RENO-WARNER/UTAH-TECH-CUBESAT/DOCUMENTATION/reports.md

# Utah Tech CubeSat: Reports Guide
## Contents

* [Intro](#intro)
* [Headers](#header)
* [Reports](#reports)
	* [Function](#function)
	* [Design](#design)
	* [Schematic](#schematic)
	* [Layout](#layout)
	* [Purchasing](#purchasing)
* []

## Intro
These reports will:
* Allow everyone to work independently
* Allow everyone to prove their work in a structured way.
* Allow everyone to understand 

**Report Content:**
Each subsystem development phase requires submitting the following reports:

## **Headers**
Each report will include a header with designated spaces for digital signatures through Git commits from:

* Subsystem Members
* Relevant Subsystem Leaders (if changes impact other subsystems)
* System Engineers
* Project Manager

[Template](./TEMPLATE/header.md)

**Don't fill in names in the header, only the associated person will sign**

**Don't forget to change the template name to your subsystem**

**When a revision needs to be made after a report has already been signed off, clone the header and increase the version number.**

## Reports
* [Function](#function)
* [Design](#design)
* [Schematic](#schematic)
* [Layout](#layout)
* [Purchasing](#purchasing)

### Function:
State the main functions of the subsystem along with the supporting functions.

[Template](./TEMPLATE/function.md)

Use ChatGPT / Gemini to get a good idea of the functions you will potentially need along with the supporting functions.
Go into detail with the functions as these need to represent all actions that your subsystem has. The functions do not need to include specific values for instance:

**DO**: The reation wheels will rotate at a speed that will allow the cubesat to track an ground station.

**DON'T**: Have motors that will spin at 1300 RPM.

This is because the design report will include all the calculations.
This will allow easy recaculation if our parameters change.

**Resources**
* [ASU Requirements List](https://dixiestate-my.sharepoint.com/:x:/g/personal/d00441759_utahtech_edu/EQHiULvhAddBqsvwDBeLyc0BcwGK4VwTQxvXV8os65FvTg)

### Design:

**Components**
This will be a list of all the active components needed.
E-Fuse 

**Analysis and Calculations**

for example:

**Selection**

Finally a Block Diagram of all the active components will be needed along will the power and communication between the components.

[Template](./TEMPLATE/design.md)

**Resources**
* Block Diagrams:
	* [Oresat](https://oresat.github.io/pub/OreSat0.5_Block_Diagram_v5.5_2023-04-025.pdf)
	* [Quetzal-1](https://github.com/Quetzal-1-CubeSat-Team/quetzal1-hardware) (Click the respecting subsystem)
* Papers
* OpenSource Satellites
* Spark

**[Easy Block Diagram Generator](https://app.diagrams.net/)**

### Schematic:

[Template](./TEMPLATE/schematic.md)

Creating a Schematic
Schematics will use the Utah Tech Cubesat Template

Everyone will use a Heicharchal Document
REFRENCE.schdoc will be used as

An Image of your Schematic

Use Template from Altium Designer Workspace make sure to fill out

Subsystem
Section
Version
Date

### Layout:

[Template](./TEMPLATE/layout.md)

### Test:
Describe test procedures to verify all functionalities.
### Reliability:
Analyze potential failure points and propose mitigation strategies.
### Purchasing
Request purchase approvals for components, consumables, and one-time purchases.

**Reports maybe excluded if they don't apply to your subsystem(eg. Structure)**
