RENO-WARNER/UTAH-TECH-CUBESAT/CONTROL/design.md

Gimbal Motors
* GBM4008H-150T
	* 46 mm Diameter
	* 21 mm Height
	* 0608 Bearing !!!!!
	* Voltage: 12V
	* 24N / 22P
* GM3506 
	* 18 OD 12 ID 4 W
	* 40 mm Diameter
	* 18 mm Motor Height
	* Voltage: 12 ~ 16 V
	* 24N / 22P
* GM2804 
	* 35 mm Diameter
	* 15.2 mm Height
	* Voltage: 10 V
* GBM2804H-100T
	* 35 mm Diameter
	* 15.2 mm Height
	* Voltage: 10 V
	* 12N/14P

* 0.5 W

8 PWM pins
	Each with gate drivers to pick which to control

* DRV8210 DRL
	* 1.65 ~ 11 V
	* MAX Amp 1.76 A
	* AutoSleep
	* 2x PWM

Min Current 1.1 A

* MCT8314Z
 	* SPI
	* 4.5V ~ 40 V
	* 1.5 A peak
	* Sensed
* MCT8315Z
	* SPI
	* 4.5V ~ 40 V
	* 4 A peak
	* Sensed
* MCT8316Z(Q1)
	* SPI
	* 4.5V ~ 40 V
	* 8 A peak
	* Sensed
* DRV10970
	* 4.5V ~ 20 V
	* 3 A peak

* Definetely the SPI variant to get more Information
* Most likely the highest power
* MCT8316Z
	Has a way to count rotations Fgout to create closed loop control on speed!!!
