RENO-WARNER/UTAH-TECH-CUBESAT/POWER/DOCUMENTATIONS/REPORTS/design.md

Power Providers
	* Overvoltage Protection

Power consumers
	* Overcurrent Protection

Multiple Power Providers
	* ORed together 

SPI bus design:

No isolation (due to 3.3V operation)
Considering tristate buffers to remove components from the bus

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

EFUSES
* LM25069

	* MOSFET
	* 19.5 V > Gate

EFuses
	50 mA -> 10 Amps
	Enable
	Fault-Preferablly

	* STM32
		3.3 V
		1 - 1.75 A
		Tri State Enable/Fault which is nice but hard to use.

	INTERNAL FET 
	* TPS24700 
		* Enable is Active high
		* Fast Trip!
		* Adjustable
		* 8 pins
		* Pgb Active-low used to determine status.
		* No overvoltage
		
	* TPS2471X
		* Active-high enable
		* No overvoltage
		* Adjustable Current

	* LM25069/LM25061
		* 0.25 - Inf Amps
		* Overvoltage
		* Pull Down needed to shut off. So turn on allows every component, which could cause infinite loop?

* ANALOG

IDEAL DIODE
	Enable Preffered
	30 mA max reverse current
	Prefer Overvoltage Protection
	ORing
	> 10 Amps

* Power Montiors
	* INA260
		* CURRENT / VOLTAGE
		* 1.25 mA
		* 1.25 mV
		* 10 mW

		* 0.5 mA
	* INA745B
		* CURRENT ? VOLTAGE / TEMP / CHARGE / ENERGY
		* 1.2 mA
		* 3.125 mV
		* 125 mC
		* 240 uW
		* 75 uC

		* 1 mA
	* INA780B
		* CURRENT ? VOLTAGE / TEMP / CHARGE / ENERGY
		* ~~2.4 mA~~
		* 3.125 mV

		* 1 mA

		* ~~85 Volt~~
	* INA740B
		* CURRENT ? VOLTAGE / TEMP / CHARGE / ENERGY
		* 1.2 mA
		* 3.125 mV
		* 125 mC
		* 240 uW
		* 75 uC

		* 1 mA

		* ~~85 Volt~~
