RENO-WARNER/UTAH-TECH-CUBESAT/COMMUNICATION/DOCUMENTATION/REPORTS/design.md

* Transcievers
	* LORA
		* E22-400M30S
			* 433MHz/470MHz
			* 1W
			* 0.018 kKbps ~ 37.5 Kbps
			* 2.5 V ~ 5.5 V
			* SPI 
			* SX1268
			* Current
				* TX: 650 mA
				* RX: 14 mA
			* RX Sensitivity: -150 dBm
		* ~~E32-400M20S~~
			* 433/470 MHz
			* ~~100 mW~~
			* 0.018 kKbps ~ 37.5 Kbps
			* 3.3 V ~ 5.5 V
		* ~~E32-400M30S~~
			* 433/470 MHz
			* 1 W
			* 0.018 kKbps ~ 37.5 Kbps
			* 3.3 V ~ 5.5 V
			* SPI 
			* SX1278
			* Current
				* TX: 650 mA
				* RX: 19 mA
			* ~~RX Sensitivity: -124 dBm~~

* RF Detectors
	* LMV221
		* 50 Mhz ~ 3.5 Ghz
		* WSON
	* LMH2100
		* 50 Mhz ~ 4.0 Ghz
		* ~~DSBGA~~

Capacitance
Resistor
8.2 pF ~ 22.0 nF 

LMV221
-5 dBm to -45 dBm

Max Transciever Power: 30 dBm
Coupler as to be atleast 35 dBm

TTM TECHNOLOGIES
X4C09F1-30S
	* 0.075 dB
	* 33.0 dB

30 dBm
-30 dBm

REV

FWD
ATTENUATOR
at least 
5 prefferably 10 db.

SUSUMU
