RENO-WARNER/UTAH-TECH-CUBESAT/COMMAND/function.md

# Utah Tech CubeSat: COMMAND Function Report
---
### COMMAND Function V1
**Subsystem Members**
* Riley Pitcher
* Larry Burke
* Reno Warner

**Subsystem Leader**
* Reno Warner

**System Engineers**
* Riley Pitcher
* _

**Project Manager**
* _
---
* Signal processing and System Control
	* Data Processing and Storage
		* Store image data
		* Comunicate with watchdogs to ensure system integrity
		* Monitor sensor and system health
	* Command execution
		* Control Payload Operations
  * 		* Send instructions to ADCS
* Telemetry Management
	* Communications telling when to transmit images and data
		* Send instructions to RF module
		* Use sensor data to calculate attitude
