RENO-WARNER/UTAH-TECH-CUBESAT/CONTROL/notes.md

### Reaction Wheels
* DC Motor: https://www.sparkfun.com/products/20441
### Magnetorquer

### Star tracker
