RENO-WARNER/UTAH-TECH-CUBESAT/DOCUMENTATION/team.md

# Utah Tech CubeSat: Team

## Program Manager
* RENO WARNER
## System Engineers
* Larry Burke
* Riley Pitcher
## COMMUNICATION
* Patrick Robanske
* Adam DiMaio
## CONTROLS
* Ben Sherman
* Trace Shafer
## POWER
* Shands Alexander
## PAYLOAD
* Rex Morgan
## STRUCTURE
* Berk Mair
* Korbin Burton
##  GROUND
