RENO-WARNER/UTAH-TECH-CUBESAT/DOCUMENTATION/info.md

CSLI Document: [LINK](https://oresat.github.io/mission/oresat-2016-csli-application-r6-PUBLIC.pdf)

Tips

All Capacitors are rated X7R 
-55C - 125C
Voltage Rating 10V.
Use application note if higher
