RENO-WARNER/UTAH-TECH-CUBESAT/COMMUNICATION/Progress Report Week 1.pdf

## CubeSat: Communications

### Week 1 Progress Report

Capstone Progress Report | Page 1 of 3

----------------------------------------------------- HOURS

Team Member First Last | Hours this Week | Total Hours since Aug 19 | Signature you verify that hours of all team members are reported truthfully
Braden Williams | 50 | 50 | Braden Williams
Adam Dimaio | 14 | 14 | Adam Dimaio
Patrick Robanske | 20 | 20 | Patrick Robanske
Ryley Horrocks | 10 | 10 | Ryley Horrocks

----------------------------------------------------- TIMELINE

Design Review | Expected Presentation Date | Status | Completion Date
Conceptual Design Review | 9/4/2024 | IN PROGRESS

Preliminary Design Review

Critical Design Review

Test Readiness Review

Test Results Review

Improvement Review

Final Review

Exhibition

----------------------------------------------------- ACTION REPORT

Team Member First Last | Action Report List actions taken this week towards your in-progress review. Give details using Research & Analyze, Design, Prototype, Test, and Report.
Braden Williams | Research & Analyze • Research Rf subsystems and their components • Research FCC regulations and limits • Research Altium best practices for RF design • Research Earth Station Grant
Patrick Robanske | Research & Analyze • Research Rf subsystems and their components • Research FCC regulations and limits • Research Altium best practices for RF design • Research Earth Station Grant • Began Filling out preliminary paperwork for Earth Station Grant • Began sourcing parts for servo control • Began researching radiating element solutions • Began contact with IT department for all security concerns
Adam Dimao | Research & Analyze • Researched and analyzed earth station reports from varies universities. • Research FCC regulations. • Contacted Facilities for Installation of ground station.
Ryley Horrocks | Research & Analyze • Researched and analyzed earth station reports from varies universities. • Contacted a local contractors to gather supplies and equipment. • Contacted Facilities for Installation of ground station.

----------------------------------------------------- ACTION PLAN

Team Member First Last | Action Plan List actions you plan to take this week towards your reviews. Give details using Research & Analyze, Design, Prototype, Test, and Report.
Braden Williams | Research & Analyze • Contact local SatCom authorities. • Research Specific materials and equipment for Earth station and module • Write grant summary for our earth station. Design • Design setup flowchart and specify parts see what other universities have done.
Adam DImaio | Research & Analyze • Look into components to build the earth station • Contact Facilities about mounting ground station Design • Design setup flowchart and specify parts see what other universities have done.
Patrick Robanske | Research & Analyze • Maintain contact with facilities and IT for all installation . • Research Specific materials and equipment for earth station and module • Write grant summary for our earth station. Design • Design setup flowchart and specify parts see what other universities have done.
Ryley Horrocks | Research & Analyze • Research Specific materials and equipment for Earth station and module • Contact local contractors to price out standard housings Design • Design setup flowchart and specify parts see what other universities have done.
