RENO-WARNER/UTAH-TECH-CUBESAT/SOFTWARE/ORBIT/ISS(51.6).png

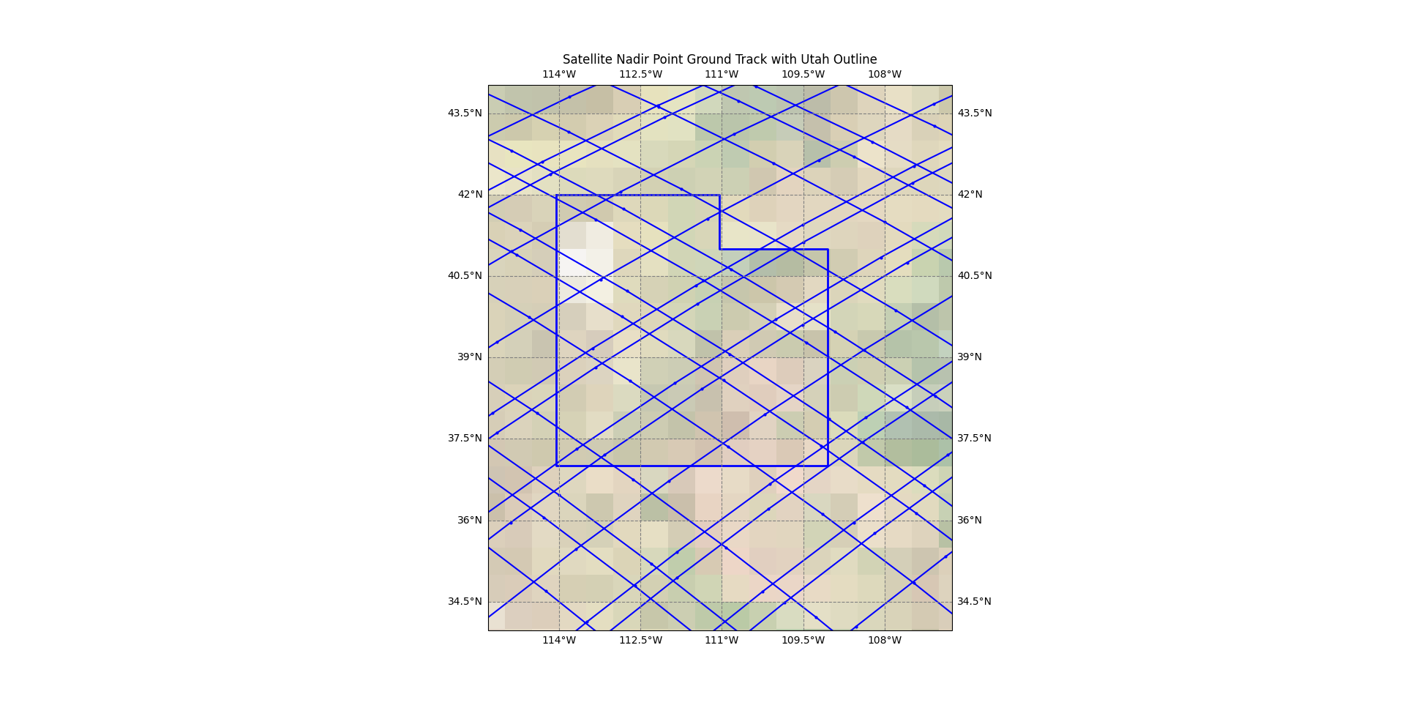
SOFTWARE/ORBIT/ISS(51.6).png
