RENO-WARNER/UTAH-TECH-CUBESAT/SOFTWARE/ORBIT/SUN(98.2).png

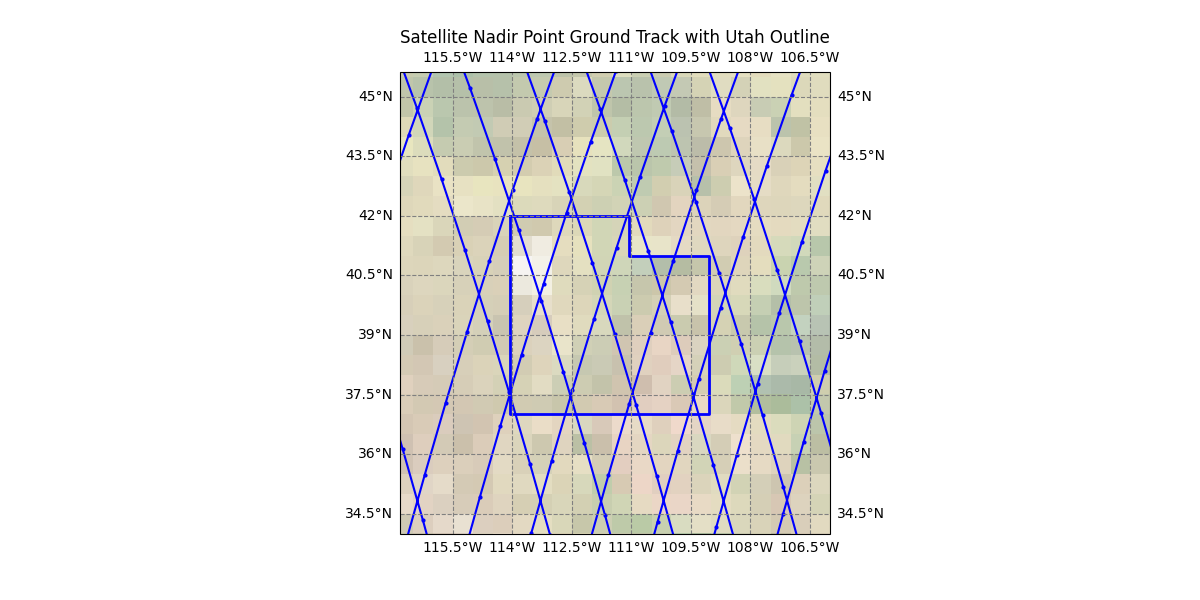
SOFTWARE/ORBIT/SUN(98.2).png
