RENO-WARNER/UTAH-TECH-CUBESAT/DOCUMENTATION/TEMPLATE/purchasing.md

# Utah Tech CubeSat: Template Function Report
---
### TEMPLATE Function V1
**Subsystem Members**
* _
* _

**Subsystem Leader**
* _

**System Engineers**
* _
* _

**Project Manager**
* _
---
