RENO-WARNER/UTAH-TECH-CUBESAT/STRUCTURE/CubesatSpecs.pdf

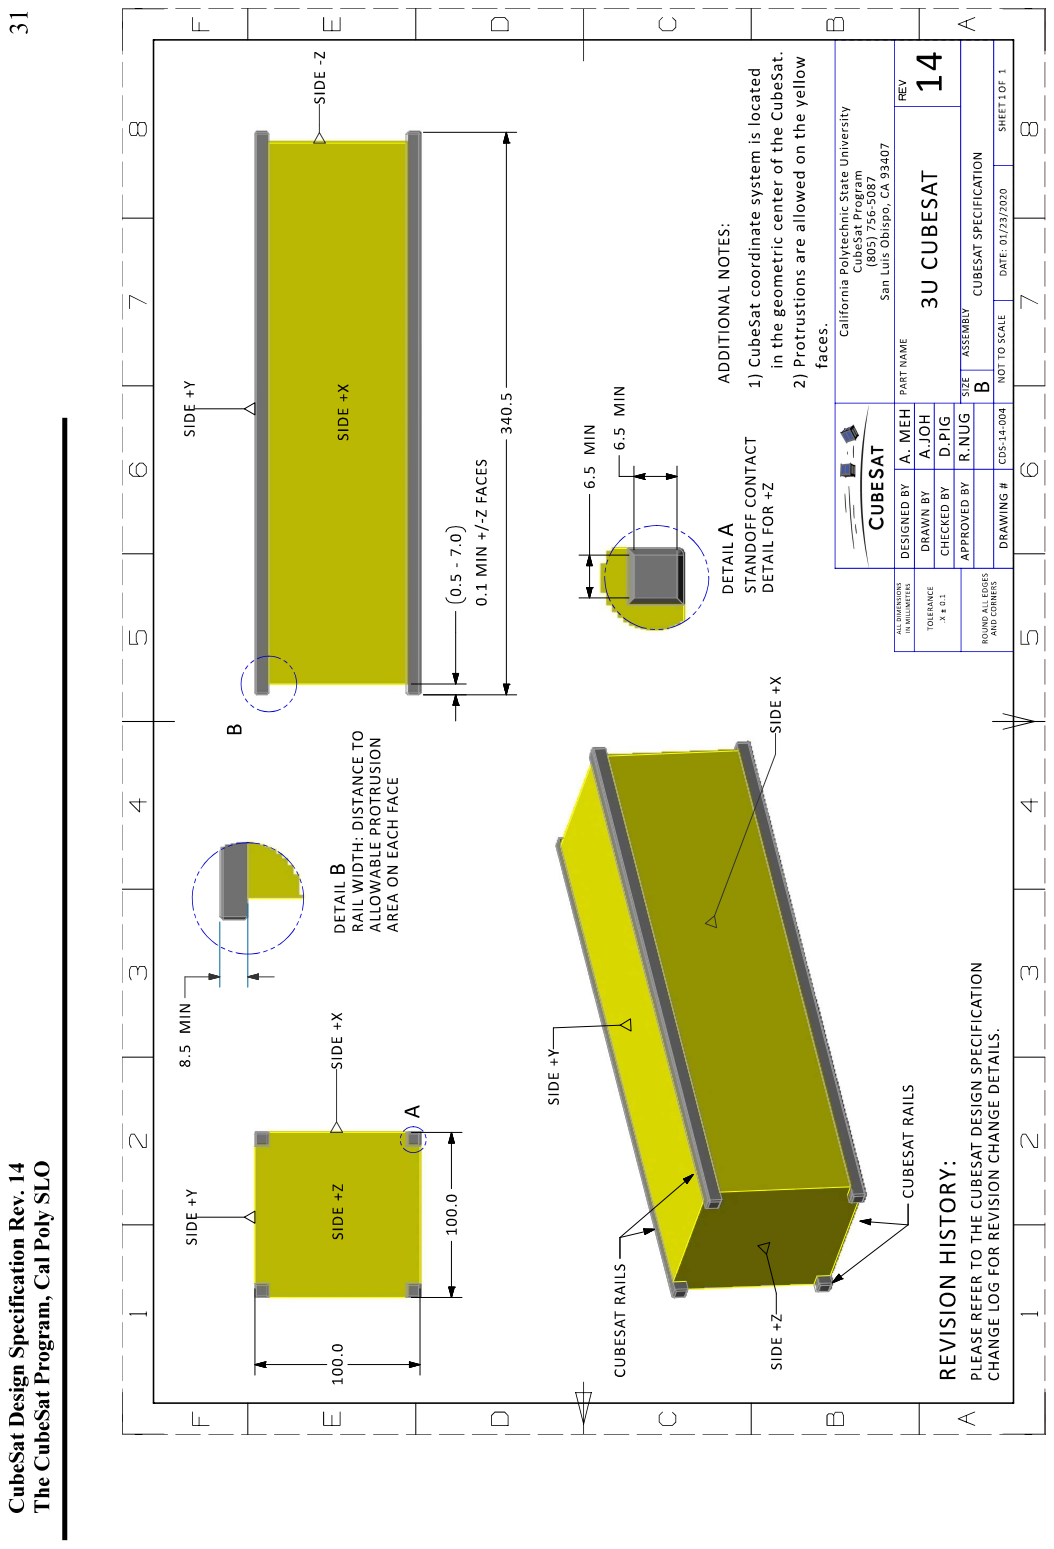
[picture p5: page 1]
