RENO-WARNER/UTAH-TECH-CUBESAT/SOFTWARE/STAR/src/main.rs

use std::fs::File;
use std::io::{self, BufRead};
use std::path::Path;
use std::str::FromStr;

//Progress
//Threshold X
//Find Stars X
//Centroiding X: Could be improved
//Sort Stars X

//Database
//Get RA and DEC X
//Confirm RA and DEC X

//Something is wrong with pixel -> Spatial

//OPTIMIZE
//OPIIMIZE
//OPTIMIZE

fn main() {
	let mut instant = std::time::Instant::now();
	let star_database = Database::generate_stars().unwrap();
	println!("Database loaded in {:?}", instant.elapsed());
	instant = std::time::Instant::now();
	let angle_database = Database::generate_angle(&star_database);
	println!("Angle database generated in {:?}", instant.elapsed());

	let star_264 = star_database.iter().enumerate().find_map(|(index,star)| (star.id == 264).then_some((star,index))).unwrap();
	let star_403 = star_database.iter().enumerate().find_map(|(index,star)| (star.id == 403).then_some((star,index))).unwrap();
	let star_542 = star_database.iter().enumerate().find_map(|(index,star)| (star.id == 542).then_some((star,index))).unwrap();

	println!("Star 264 {:?} {:?} {:?}",star_264.0.right_ascension.to_degrees(),star_264.0.declination.to_degrees(),star_264.1);
	println!("Star 403 {:?} {:?} {:?}",star_403.0.right_ascension.to_degrees(),star_403.0.declination.to_degrees(),star_403.1);
	println!("Star 542 {:?} {:?} {:?}",star_542.0.right_ascension.to_degrees(),star_542.0.declination.to_degrees(),star_542.1);

	println!("Star 264 / Star 403 Actual Angle: {:?} rad",Database::Star::angle(star_264.0,star_403.0));
	println!("Star 264 / Star 542 Actual Angle: {:?} deg",Database::Star::angle(star_264.0,star_542.0));
	println!("Star 403 / Star 542 Actual Angle: {:?} deg",Database::Star::angle(star_403.0,star_542.0));

	instant = std::time::Instant::now();
	let img = image::open("./catalog/test.png").unwrap().to_luma8();
	println!("Image loaded in {:?}", instant.elapsed());
	// Convert to binary with a threshold
	let threshold = 128; // Adjust this as needed
	instant = std::time::Instant::now();
	let binary_img = ImageProcessing::threshold_image(&img, threshold);
	println!("Thresholded in {:?}", instant.elapsed());

	//binary_img.save("./catalog/test.threshold.png").expect("Failed to save the image");
	// // Find all bright stars
	instant = std::time::Instant::now();
	let mut stars = ImageProcessing::find_stars(&binary_img);
	println!("Stars found in {:?}", instant.elapsed());

	stars.sort_by(|a, b| b.luminosity.partial_cmp(&a.luminosity).unwrap());

	// //Sort Star
	// let focal_length = 1.0;
	for star in stars.iter_mut() {
		println!("{:?}", star);
		// Translate the coordinate to the center of the image
		let (u, v) = ImageProcessing::translate_to_center(&img, star.center);
		// Apply the inverse Mercator projection
		let focal_length = 49.0 * (10.0 as f32).powi(-3);//Could be 0.049
		let pixel_size = 22.2 * (10.0 as f32).powi(-6);
		// Project to 3D space using the focal length
		star.vector = ImageProcessing::project_to_vector(u, v, focal_length, pixel_size);
	}

	let a = &stars[0]; 
	let b = &stars[1];
	let c = &stars[2];
	println!("Star 264 / Star 403 Camera Angle: {:?}",(a.vector.1.sin() * b.vector.1.sin() + a.vector.1.cos() * b.vector.1.cos() * (a.vector.0 - b.vector.0).cos()).acos());
	println!("Star 264 / Star 542 Camera Angle: {:?}",(a.vector.1.sin() * c.vector.1.sin() + a.vector.1.cos() * c.vector.1.cos() * (a.vector.0 - c.vector.0).cos()).acos());
	println!("Star 403 / Star 542 Camera Angle: {:?}",(b.vector.1.sin() * c.vector.1.sin() + b.vector.1.cos() * c.vector.1.cos() * (b.vector.0 - c.vector.0).cos()).acos());

	instant = std::time::Instant::now();
	let star_i = Identification::identify(stars, &angle_database).unwrap();
	println!("Identified in {:?}", instant.elapsed());


}

mod Database {
	use std::io;
	use std::fs::File;
	use std::io::BufRead;

	static FILENAME: &str = "./catalog/bsc5.dat";

	#[derive(Debug)]
	pub struct Star {
		pub id: u16,
		pub right_ascension: f32,
		pub declination: f32,
		vmag: f32,
	}

	impl Star {
		pub fn angle(a: &Star, b: &Star) -> f32 {
			(a.declination.sin() * b.declination.sin()
				+ a.declination.cos() * b.declination.cos() * (a.right_ascension - b.right_ascension).cos())
				.acos()
		}
	}
    fn parse_star_line(line: &str) -> Option<Star> {
		use std::str::FromStr;

		let id = u16::from_str(&line[0..4].trim()).ok()?;

		// Right Ascension
		let ra_h = u8::from_str(&line[75..77].trim()).ok()? as f32;
		let ra_m = u8::from_str(&line[77..79].trim()).ok()? as f32;
		let ra_s = f32::from_str(&line[79..83].trim()).ok()?;
		let ra = (ra_h * 15.0 + ra_m / 4.0 + ra_s / 240.0).to_radians();
	
		// Declination
		let dec_sign = if &line[83..84] == "+" { 1.0 } else { -1.0 };
		let dec_d = u8::from_str(&line[84..86].trim()).ok()? as f32;
		let dec_m = u8::from_str(&line[86..88].trim()).ok()? as f32;
		let dec_s = u8::from_str(&line[88..90].trim()).ok()? as f32;
		let dec = dec_sign * (dec_d + dec_m / 60.0 + dec_s / 3600.0).to_radians();
	
		// Visual Magnitude
		let vmag = f32::from_str(&line[102..107].trim()).ok()?;

		return Some(Star {
			id,
			right_ascension: ra,
			declination: dec,
			vmag,
		});
	}
	fn read_stars_from_file(filename: &str) -> io::Result<Vec<Star>> {
		let mut stars = Vec::new();
	
		let file = File::open(filename)?;
		for line in io::BufReader::new(file).lines() {
			if let Ok(line) = line {
				if let Some(star) = parse_star_line(&line) {
					stars.push(star);
				}
			}
		}

		stars.sort_by(|a, b| b.vmag.partial_cmp(&a.vmag).unwrap());

		return Ok(stars)
	}
	pub fn generate_stars() -> io::Result<Vec<Star>> {
		return read_stars_from_file(self::FILENAME);
	}
	pub fn generate_angle(stars: &Vec<Star>) -> Vec<super::Identification::AnglePair> {
		use itertools::Itertools;

		return stars.iter().enumerate().tuple_combinations().map(|(a,b)| {
			return ((a.0 as u16,b.0 as u16),Star::angle(a.1,b.1));
		}).collect();
	}
}

mod Identification {
	type StarID = u16;
	pub type Pair = (StarID, StarID);
	pub type AnglePair = (Pair, f32);

	#[derive(Debug)]
	struct Star {
		id: u16,
		ascension: f32,
		declination: f32,
	}

	fn find_pairs(a: &super::ImageProcessing::Star,b: &super::ImageProcessing::Star, database: &Vec<AnglePair>) -> Option<Vec<Pair>> {
		const EPSILON: f32 = 0.00015;

		let target: f32 = (a.vector.0.sin() * b.vector.0.sin() + a.vector.0.cos() * b.vector.0.cos() * (a.vector.1 - b.vector.1).cos()).acos();

		return Some(database.iter().enumerate().filter_map(|(entry,angle)| {
			if (angle.1 - target).abs() <= EPSILON {

				return Some(angle.0);
			}

			return None;
		}).collect::<Vec<Pair>>());
	}
	
	fn find_common_star(
		ab: &[Pair],
		ac: &[Pair],
		exclude: &[StarID],
	) -> Vec<StarID> {

		return ab.iter().filter_map(|(a,b)| {
			return ac.iter().find_map(|(c,d)| {
				return (c == a || c == b).then_some(*c).or((d == a || d == b).then_some(*d));
			});
		}).collect();
	}

	pub fn identify(stars: Vec<super::ImageProcessing::Star>, database: &Vec<AnglePair>) -> Result<StarID, &'static str> {
		let size = stars.len();

		if size < 4 {
			return Err("Not enough stars");
		}
	
		// Repeat over every combination of three stars from the sensed stars
		use itertools::Itertools;
		for (iteration,(i, j, k)) in stars.iter().tuple_combinations().enumerate() {
			println!("Iteration: {:?}",iteration);
			println!("i: {:?}, j: {:?}, k: {:?}", i, j, k);

			// FIX: Increase speed by removing stars if there is no possible pair.

			let potential_pairs_ij = match self::find_pairs(i, j, database) {None => continue,Some(asdf) => asdf};//Fail if no pairs are found
			let potential_pairs_ik = match self::find_pairs(i, k, database) {None => continue,Some(asdf) => asdf};//Fail if no pairs are found
			let potential_pairs_jk = match self::find_pairs(j, k, database) {None => continue,Some(asdf) => asdf};//Fail if no pairs are found
	
			// for pair in potential_pairs_ij.iter() {
			// 	println!("IJ: {:?}",pair);
			// }
			// for pair in potential_pairs_ik.iter() {
			// 	println!("IK: {:?}",pair);
			// }
			// for pair in potential_pairs_jk.iter() {
			// 	println!("JK: {:?}",pair);
			// }

			println!("Potential pairs");

			let mut exclude: Vec<StarID> = Vec::new();
	
			let star_i = self::find_common_star(&potential_pairs_ij, &potential_pairs_ik, &exclude);

			println!("Common Star I: {:?}",star_i);

			if star_i.is_empty() {
				continue;
			}
	
			//exclude.push(star_i.unwrap());
	
			let star_j = self::find_common_star(&potential_pairs_ij, &potential_pairs_jk, &exclude);

			println!("Common Star J: {:?}",star_j);

			if star_j.is_empty() {
				continue;
			}
	
			//exclude.push(star_j.unwrap());
	
			let star_k = self::find_common_star(&potential_pairs_ik, &potential_pairs_jk, &exclude);

			println!("Common Star K: {:?}",star_k);

			if star_k.is_empty() {
				continue;
			}
	
			println!("i: {:?}, j: {:?}, k: {:?}", star_i, star_j, star_k);

			return Ok(star_i[0]);
		}

		return Err("Could not find a match");
	}
}

// Database 1
// 
//



//ICRF
//Location(Longitude, Lattidue, Altitude)
//J2000 right ascension is on the equator. declination perpendicular to the equator

mod ImageProcessing {
	use image::{GrayImage, Luma};

	#[derive(Debug)]
	pub struct Star {
		pub center: (f32, f32),
		pub luminosity: f32,
		pub vector: (f32, f32),
	}

	impl From<&FoundStars> for Star {
		fn from(star: &FoundStars) -> Self {
			Star {
				center: star.centroid(),
				luminosity: star.pixel_count as f32,
				vector: (0.0, 0.0),
			}
		}
	}

	struct FoundStars {
		sum_x: u32,
		sum_y: u32,
		pub pixel_count: u32,
	}

	impl FoundStars {
		fn new() -> Self {
			FoundStars {
				sum_x: 0,
				sum_y: 0,
				pixel_count: 0,
			}
		}
	
		fn add_pixel(&mut self, x: u32, y: u32) {
			self.sum_x += x;
			self.sum_y += y;
			self.pixel_count += 1;
		}
	
		fn centroid(&self) -> (f32, f32) {
			(
				self.sum_x as f32 / self.pixel_count as f32,
				self.sum_y as f32 / self.pixel_count as f32,
			)
		}
	}

	pub fn threshold_image(img: &GrayImage, threshold: u8) -> GrayImage {
		let mut binary_img = GrayImage::new(img.width(), img.height());
		for (x, y, pixel) in img.enumerate_pixels() {
			let Luma([intensity]) = *pixel;
			let binary_value = if intensity > threshold { 255 } else { 0 };
			binary_img.put_pixel(x, y, Luma([binary_value]));
		}
		binary_img
	}
	pub fn find_stars(img: &GrayImage) -> Vec<Star> {
		let (width, height) = img.dimensions();
		let mut labeled = vec![0u32; (width * height) as usize];
		let mut stars = Vec::new();
		let mut current_label = 0;
	
		for y in 0..height {
			for x in 0..width {
				if img.get_pixel(x, y)[0] == 255 && labeled[(y * width + x) as usize] == 0 {
					current_label += 1;
					let mut star = FoundStars::new();
					self::label_connected_component(img, &mut labeled, x, y, current_label, &mut star);
					stars.push(star);
				}
			}
		}

		return stars.iter().map(|star| Star::from(star)).collect();
	}

	fn label_connected_component(
		img: &GrayImage,
		labeled: &mut Vec<u32>,
		start_x: u32,
		start_y: u32,
		label: u32,
		star: &mut FoundStars,
	) {
		let (width, height) = img.dimensions();
		let mut stack = vec![(start_x, start_y)];
	
		while let Some((x, y)) = stack.pop() {
			if x >= width || y >= height || img.get_pixel(x, y)[0] == 0 || labeled[(y * width + x) as usize] != 0 {
				continue;
			}
	
			labeled[(y * width + x) as usize] = label;
			star.add_pixel(x, y);
	
			// Check 8-connected neighbors
			for dy in -1..=1 {
				for dx in -1..=1 {
					if dx == 0 && dy == 0 {
						continue;
					}
					let nx = x as i32 + dx;
					let ny = y as i32 + dy;
					if nx >= 0 && ny >= 0 {
						stack.push((nx as u32, ny as u32));
					}
				}
			}
		}
	}
	pub fn translate_to_center(img: &GrayImage, coord: (f32, f32)) -> (f32, f32) {
		let (x, y) = coord;
		let center_x = img.width() as f32 / 2.0;
		let center_y = img.height() as f32 / 2.0;
	
		((x as f32) - center_x, (y as f32) - center_y)
	}
	pub fn project_to_vector(u: f32, v: f32, focal_length: f32, pixel_size: f32) -> (f32, f32) {
		let x_mm = u * pixel_size / focal_length;
		let y_mm = v * pixel_size / focal_length;

		//let r = (x_mm.powi(2) + y_mm.powi(2) + focal_length.powi(2)).sqrt();

		return (x_mm,y_mm)//(y_mm.atan2(x_mm),(focal_length / r).acos());
	}
}
//Actual
//0.06311693
//Calculated
//0.063077234

//Implement Brown Transformation


// Check if Stars > 4

//Repeat over every combination of three stars from the sensed stars
	// If too many iterations return Error

	// Find catalog stars
	
	// Get possible candiate pairs {0/1: find_pair(0,1), 0/2: find_pair(0,2), 1/2: find_pair(1,2)}

	    // Otherwise, there exists |big_i| choose 3 possibilities. Looping specified in paper.


//0.000039696
//0.00014637
//0.00002208


//Two Databases
//One for the angle between two stars sorted by combined magnitude
// Implied(12) Angle
// Implied(13) Angle
//Second for the position of the stars sorted by magnitude
//1 Declination Right_Ascension

// Convert to GrayScale
// Blur Image iwht normalized Box Filter
// Convert to Binary Black/White Scale
// Find Contours
// Compute Moment of Contour
// Compute Center of Mass from Moment
// Translate pixels so that (0,0) is centered
// Inverse Mercator Projection with ellipsoid
// Project to Vector3D

//Identify
//Databse is organized by magnitude

//Vector of Stars that are sorted by the brightest
// let stars = vec![]

// let iteration = 0;

// // Repeat over every pair of Star(i,j)
// for i in 0..stars.len() {
// for j in (i + 1)..stars.len() {

// iteration += 1;

// // Return if too many comparisons(e.g. Lose Hope)
// if iteration > MAX_ITERATIONS {
// 	return Err("Too many iterations");
// }

// //Find Possible Pair

// // Compute theta between two stars
// let theta = compute_theta(stars[i], stars[j]);
// // If angle is too wide(> FOV) continue
// if theta > FOV {
// 	continue;
// }
// // Search Database for two stars that match angle with epsilon
// // If no pair is found continue
// let potential_pair = DATABASE::search(theta, epsilon)?;
	
// // Generate possible neably stars
// let possible_nearby_stars: Vec<Star> = DATABASE::search_nearby(stars[i], stars[j], epsilon)?;//(Could be improvd)

// // DMT(Direct Match Test) List of possible candiate stars along with the possible pair
// 	// Repeat by flipping which star is at what position(e.g. STAR A == position 1 || STAR B == position 2)

// 	let quarternion = Quaternion::from_two_vectors(stars[i], stars[j]);
// 	// Compute Quaternion between A/B


// 	// For every possible nearby stars
// 		// Rotate star by quarternion
		
// 		// Repeat for every star in the image
// 			// If Star is with epsilon angle of possible nearby stars

// }
// }


// Star 403 21.454166 60.235283 8984
// Star 264 14.177083 60.716667 9005
// Star 21  8840

//IJ: (8984, 9005)
//IK: (8840, 9005)
//JK: (8840, 8984)

// IJ: (9, 2824)
// IJ: (36, 8298)
// IJ: (54, 535)
// IJ: (57, 3688)
// IJ: (72, 6979)
// IJ: (79, 8100)
// IJ: (102, 3459)
// IJ: (102, 5751)
// IJ: (103, 4665)
// IJ: (121, 8708)
// IJ: (156, 3466)
// IJ: (161, 3498)
// IJ: (182, 1636)
// IJ: (188, 5196)
// IJ: (203, 415)
// IJ: (216, 5716)
// IJ: (222, 4898)
// IJ: (229, 4320)
// IJ: (235, 324)
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
// JK: (7188, 8554)
// JK: (7250, 8091)
// JK: (7305, 8101)
// JK: (7319, 8106)
// JK: (7366, 8135)
// JK: (7381, 7579)
// JK: (7410, 7750)
// JK: (7488, 8613)
// JK: (7553, 8943)
// JK: (7595, 7945)
// JK: (7615, 8298)
// JK: (7628, 8525)
// JK: (7643, 8280)
// JK: (7705, 8645)
// JK: (7742, 8407)
// JK: (7831, 8629)
// JK: (7863, 8462)
// JK: (7863, 9042)
// JK: (7907, 8493)
// JK: (7931, 8684)
// JK: (7937, 8189)
// JK: (8171, 8349)
// JK: (8268, 8883)
// JK: (8322, 8687)
// JK: (8323, 8453)
// JK: (8359, 8964)
// JK: (8363, 8797)
// JK: (8453, 8707)
// JK: (8571, 8863)
// JK: (8623, 8630)
// JK: (8805, 9074)
// JK: (8840, 8984)
