RENO-WARNER/UTAH-TECH-CUBESAT/(commit log)

2024-08-21 Created Power Function Report
2024-08-26 Update notes.md
    Added Motor link
2024-10-14 Initialized BUS Kicad Project
    [bus.kicad_pcb, bus.kicad_sch, connector.female.kicad_sch, connector.kicad_sch, solar.cell.kicad_sch, solar.panel.kicad_sch]
2024-10-14 Initialized Command Kicad Project
    [can.kicad_sch, command.kicad_pcb, command.kicad_sch, connector.male.kicad_sch, debug.kicad_sch, isolator.kicad_sch, mcu.kicad_sch]
2024-10-14 Initialized Control Kicad Project
    [control.kicad_pcb, control.kicad_sch, imu.kicad_sch, mag.kicad_sch, magnet.module.kicad_sch, magnetometer.kicad_sch, magnetorquer.kicad_sch, sun_sensor.kicad_sch]
2024-10-14 Initialized Kicad Power Project
    [efuse.latched.kicad_sch, efuse.retry.kicad_sch, power.kicad_pcb, power.kicad_sch, qfet.kicad_sch]
2024-10-14 Initialized Communicaiton Kicad Project
    [attenuator.kicad_sch, communication.kicad_pcb, communication.kicad_sch, coupler.kicad_sch, detector.kicad_sch, transciever.kicad_sch]
2024-10-14 Added Transciever / Detector / Coupler Options
2024-10-14 EFuse / Ideal Diode Options
2024-10-14 Magnetorquer Optimization
2024-10-14 Added Connector Options along with protocols to use, outdated
2024-10-14 General Design of Motor systems
2024-10-14 Create Kicad CubeSat Library
2024-10-14 Added More to gitignore for Kicad
2024-10-22 Move Power Reports
2024-10-22 Added Motor Driver Datasheet
2024-10-22 Added Motor Driver Options
2024-10-22 Edited Schematics
    [bldc_motor_driver.kicad_sch, can.kicad_sch, command.kicad_sch, control.kicad_sch, debug.kicad_sch, magnet.module.kicad_sch, mcu.kicad_sch, monitor.kicad_sch]
2024-11-21 Add files via upload
    Deploy switch Option
2024-11-21 Create Battery Board
2024-11-23 Moved Communication Kicad
    [attenuator.kicad_sch, communication.kicad_pcb, communication.kicad_sch, coupler.kicad_sch, detector.kicad_sch, transciever.kicad_sch]
2024-11-23 Removed unkown gender connector
    [connector.kicad_sch]
2024-11-23 Updated Bus
    [bus.kicad_pcb, bus.kicad_sch, connector.male.kicad_sch, solar.cell.kicad_sch]
2024-11-23 Initiated a loop based magnetorquer optimizer
2024-11-23 Updated Control PCB / Schematics
    [bldc_motor_driver.kicad_sch, control.kicad_pcb, control.kicad_sch, imu.kicad_sch, magnet.module.kicad_sch, magnetometer.kicad_sch, magnetorquer.kicad_sch, magnetorquers.kicad_sch]
2024-11-23 Updated Power Schematic / Kicad
    [battery.kicad_sch, battery_module.kicad_sch, efuse.latched.kicad_sch, efuse.retry.kicad_sch, monitor.kicad_sch, mppt.kicad_sch, power.kicad_sch, qfet.kicad_sch]
2024-11-23 Updated Command Kicad
    [adc.kicad_sch, can.kicad_sch, command.kicad_sch, connector.male.kicad_sch, debug.kicad_sch, expander.kicad_sch, mcu.kicad_sch, temperature_sensor.kicad_sch]
2024-11-23 Updated Communication kicad
    [attenuator.kicad_sch, communication.kicad_pcb, communication.kicad_sch, communication.module.kicad_sch, coupler.kicad_sch, detector.kicad_sch, transciever.kicad_sch]
2024-11-23 Added Footprint requirements for Kicad
2024-11-23 Decrepated Components
    [imu.kicad_sch, magnet_torquers.kicad_sch, magnetometer.kicad_sch, magnetorquer.kicad_sch]
2024-11-23 Footprints that most likely will get deleted or modified.
2024-12-02 schematic design
    [attenuator.kicad_sch, battery.module.kicad_sch, battery_module.kicad_sch, bldc_motor_driver.kicad_sch, can.kicad_sch, command.kicad_sch, communication.kicad_sch, communication.module.kicad_sch]
